Waziup/OSIRRIS/media/4-x-aa-battery-holder-with-on-off-switch-01_600x600_600x600.png

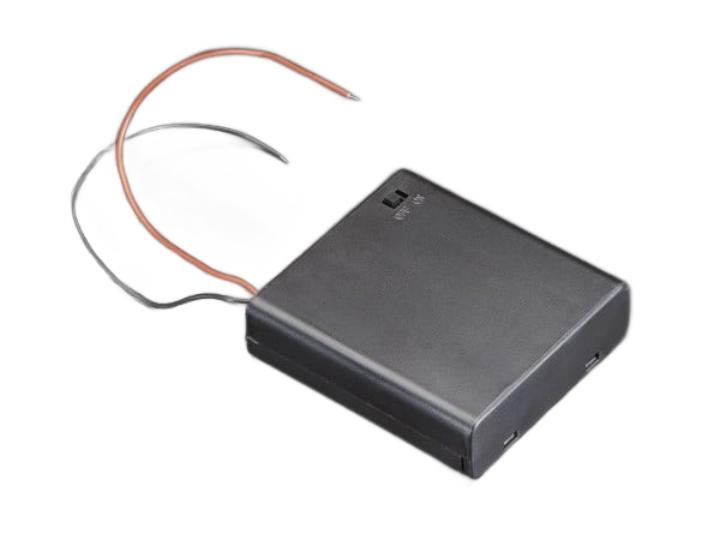
media/4-x-aa-battery-holder-with-on-off-switch-01_600x600_600x600.png
