Waziup/OSIRRIS/media/20221110_152509.jpg

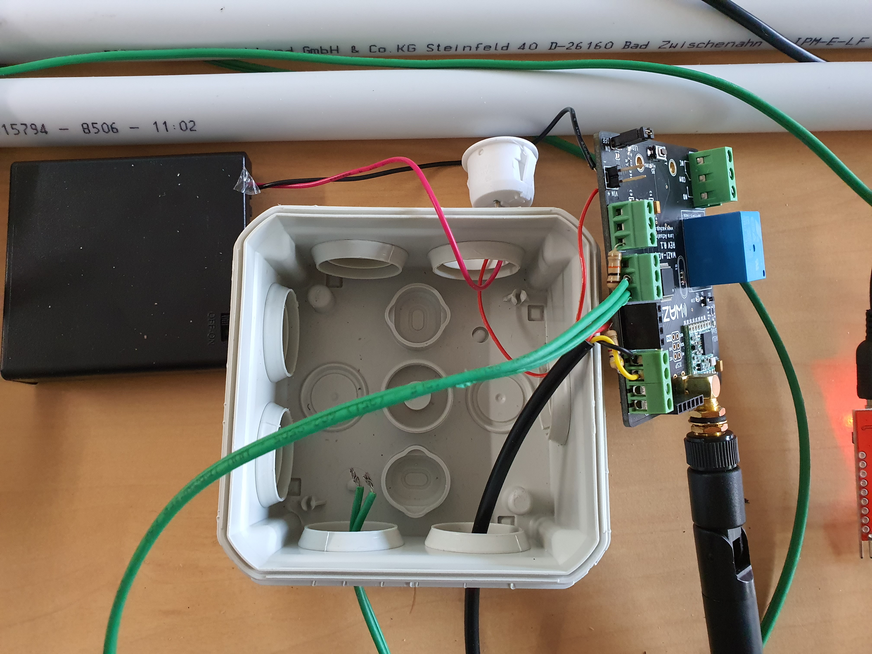
media/20221110_152509.jpg
