Waziup/OSIRRIS/media/20221110_152630.jpg

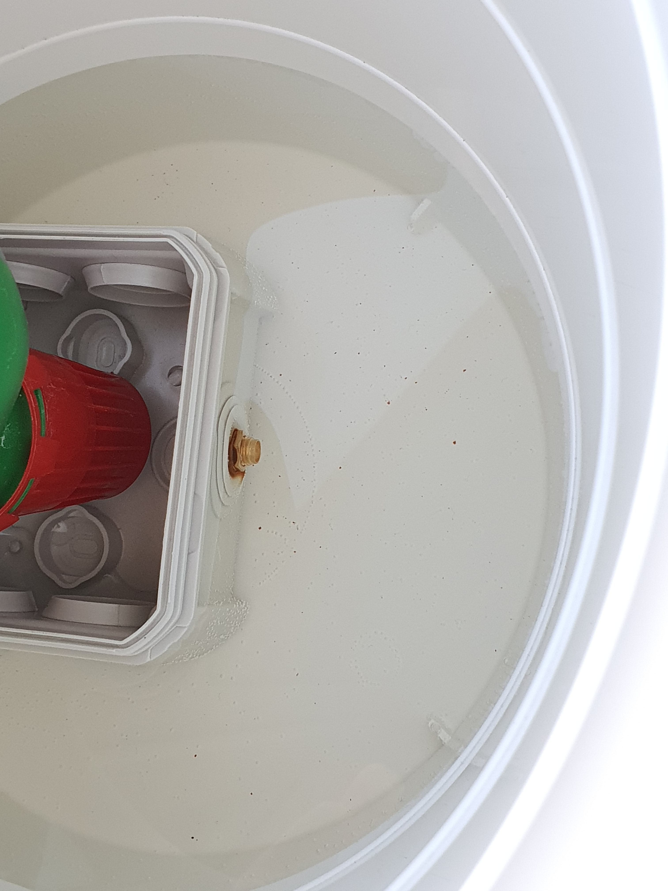
media/20221110_152630.jpg
