Waziup/OSIRRIS/media/20221111_155751_001.jpg

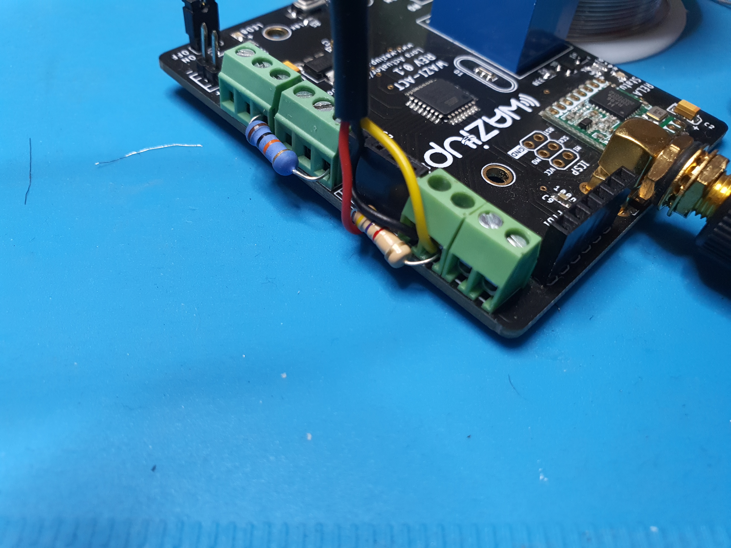
media/20221111_155751_001.jpg
