Waziup/OSIRRIS/media/20221114_112446.jpg

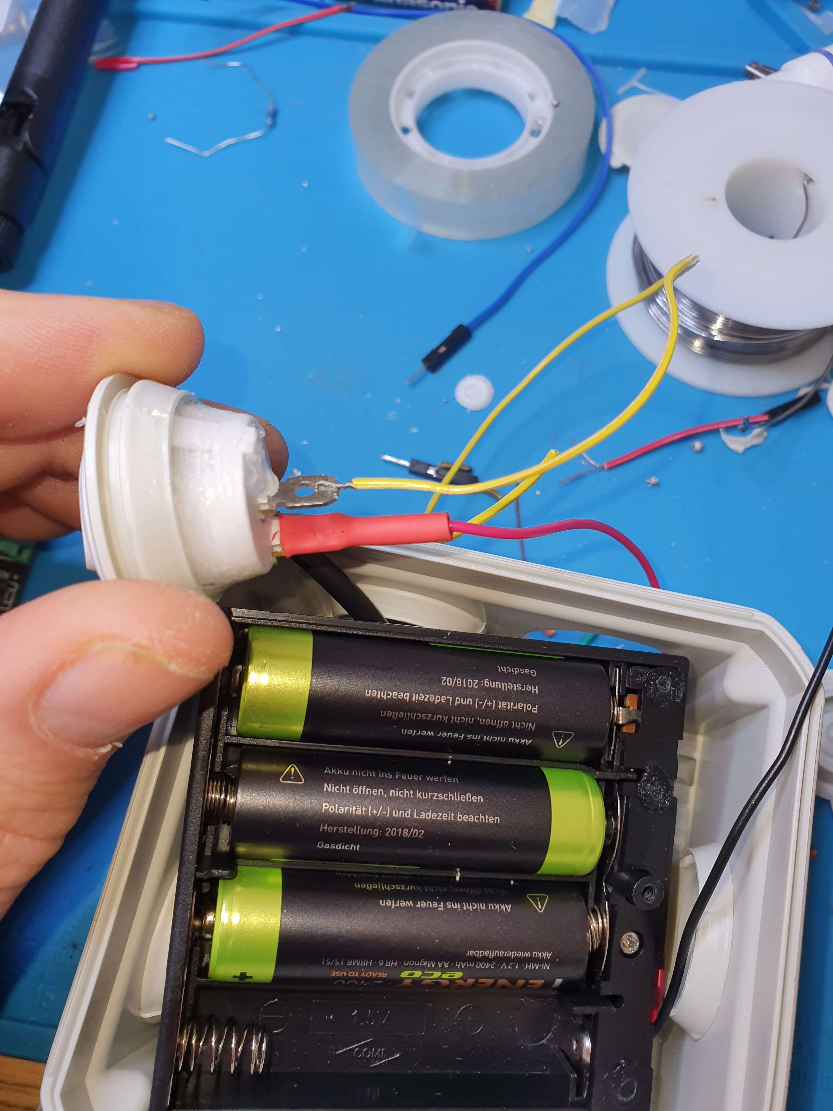
media/20221114_112446.jpg
