Waziup/OSIRRIS/media/20221117_125420.jpg

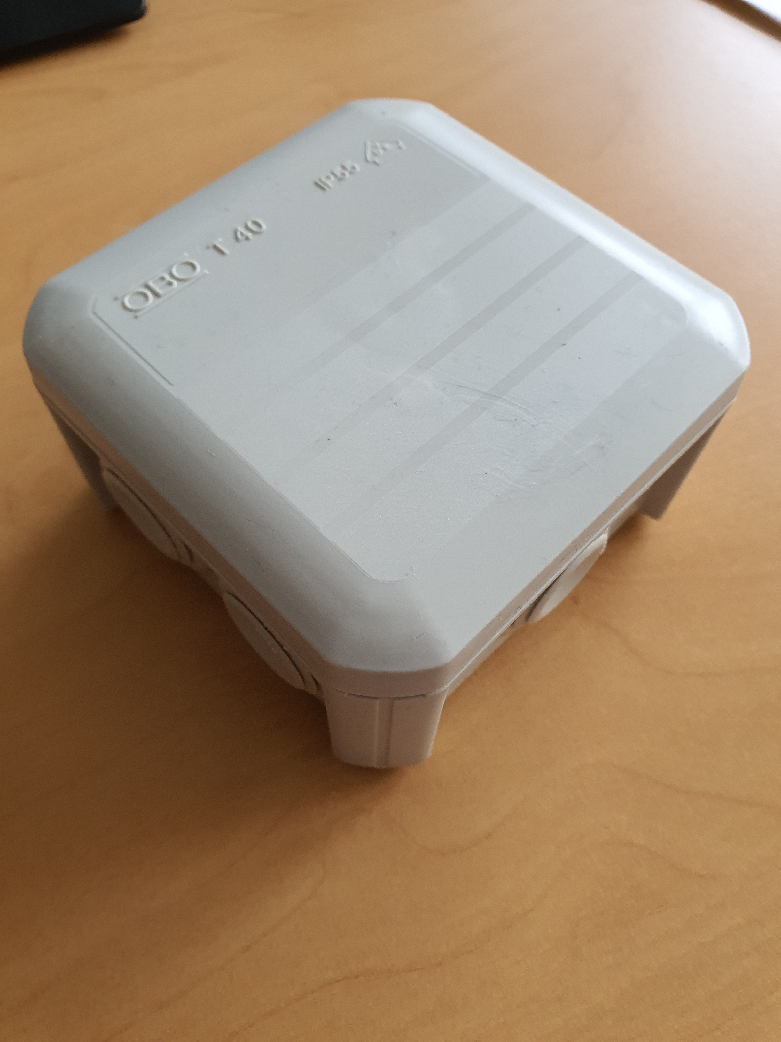
media/20221117_125420.jpg
