Waziup/OSIRRIS/media/20221117_125453.jpg

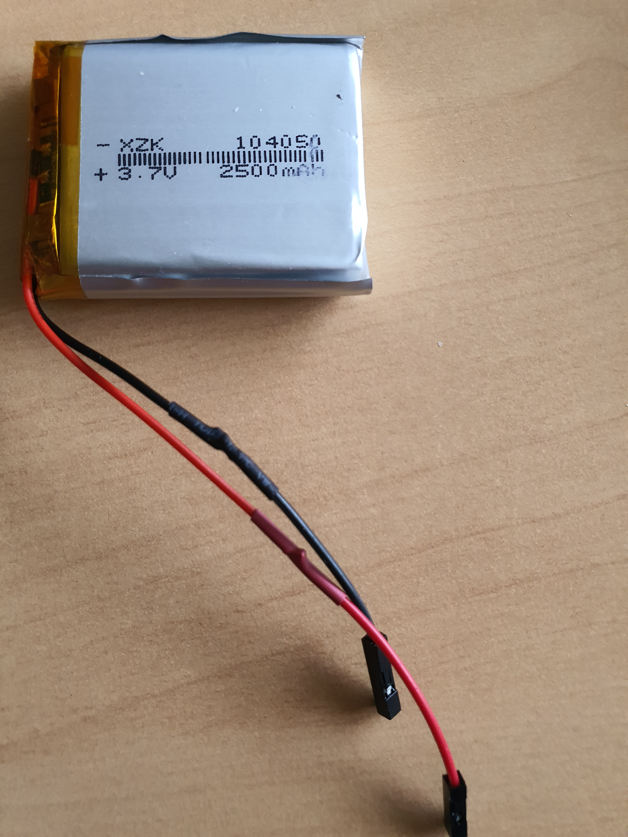
media/20221117_125453.jpg
