Waziup/OSIRRIS/media/20221117_125513.jpg

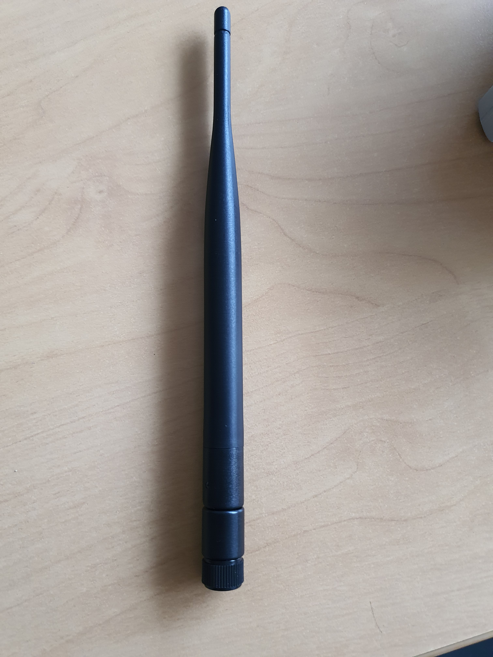
media/20221117_125513.jpg
