Waziup/OSIRRIS/media/20221118_125738_001.jpg

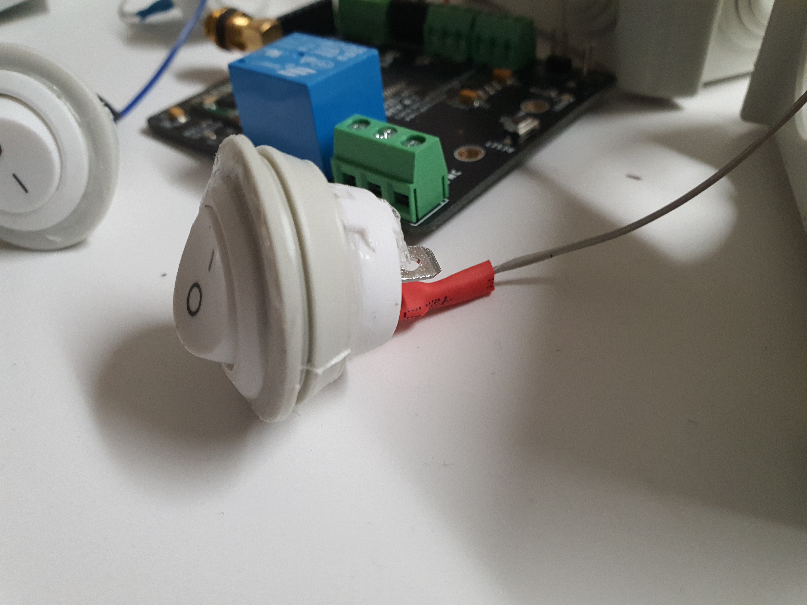
media/20221118_125738_001.jpg
