Waziup/OSIRRIS/media/20221121_114306.jpg

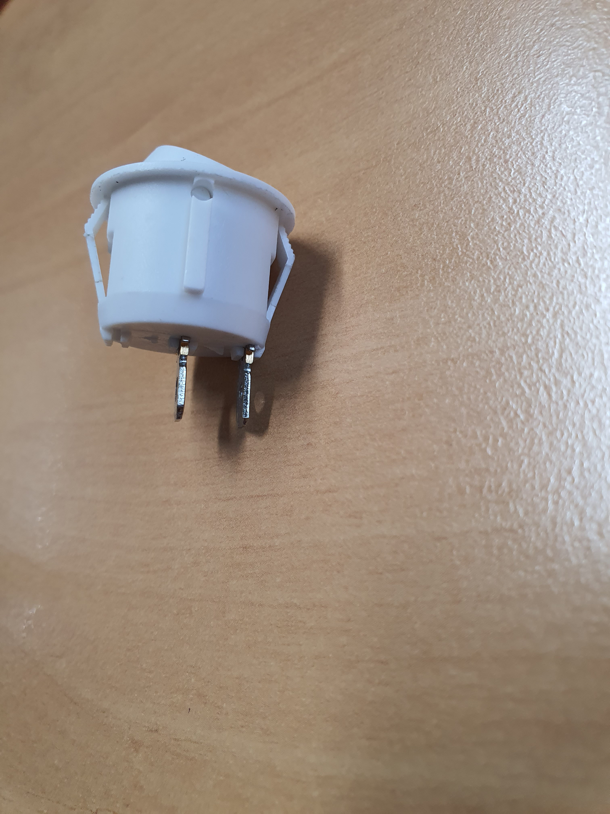
media/20221121_114306.jpg
