Waziup/OSIRRIS/media/20221121_114306.png

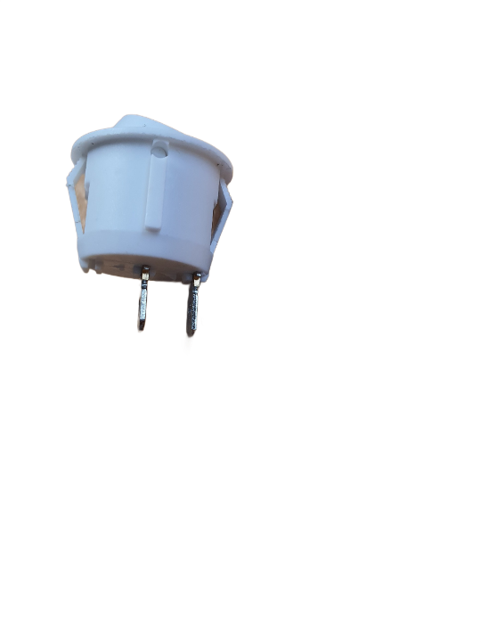
media/20221121_114306.png
