Waziup/OSIRRIS/media/antenna.png

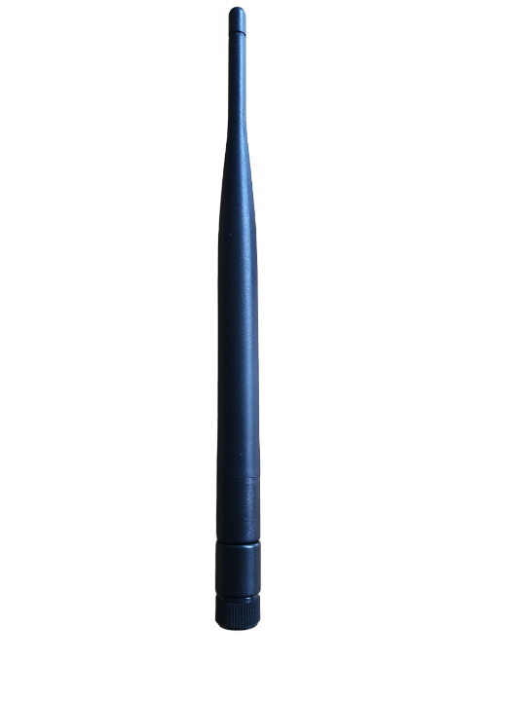
media/antenna.png
