Waziup/OSIRRIS/media/battery.png

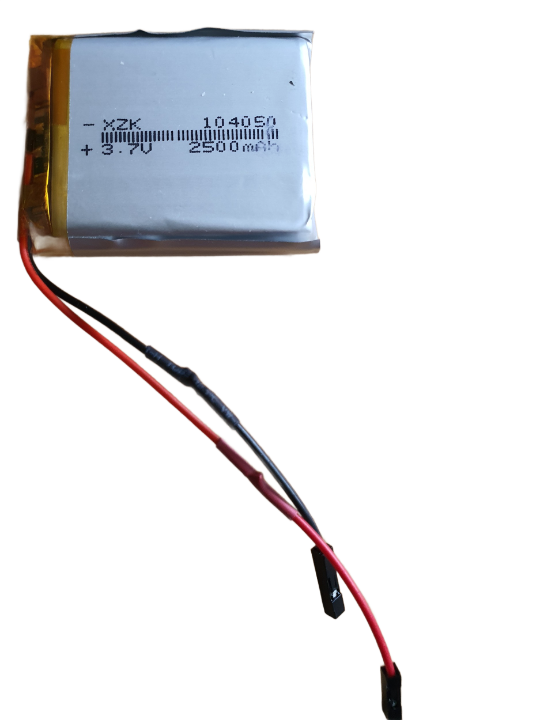
media/battery.png
