Waziup/OSIRRIS/media/box.png

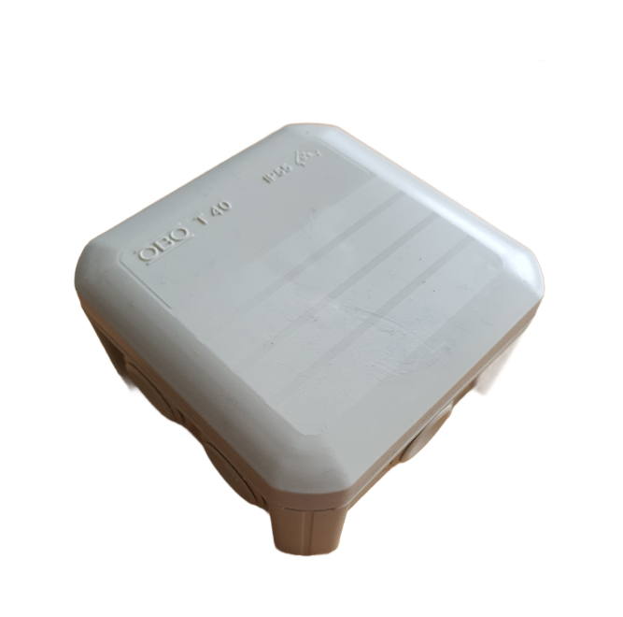
media/box.png
