Waziup/OSIRRIS/media/drip_irrigation.jpg

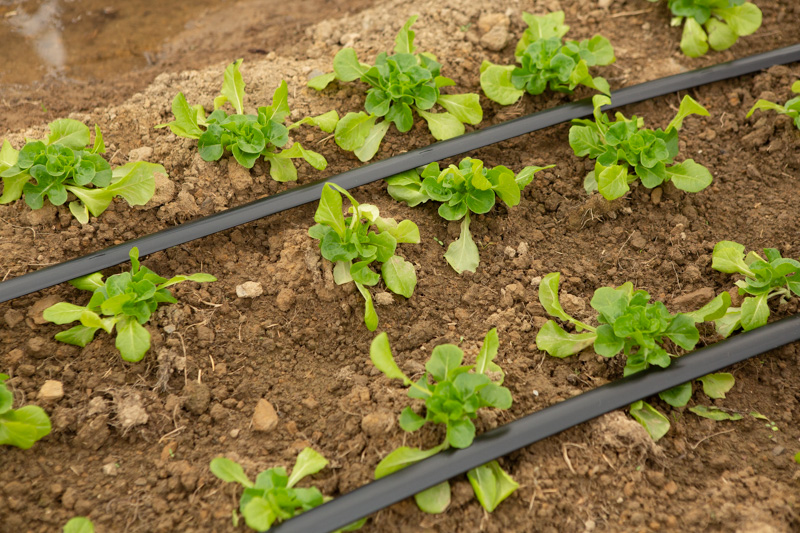
media/drip_irrigation.jpg
