Waziup/OSIRRIS/media/IMG_6713a_0349af94-5212-41f6-b86e-f112ee11bd61_2048x2048.webp

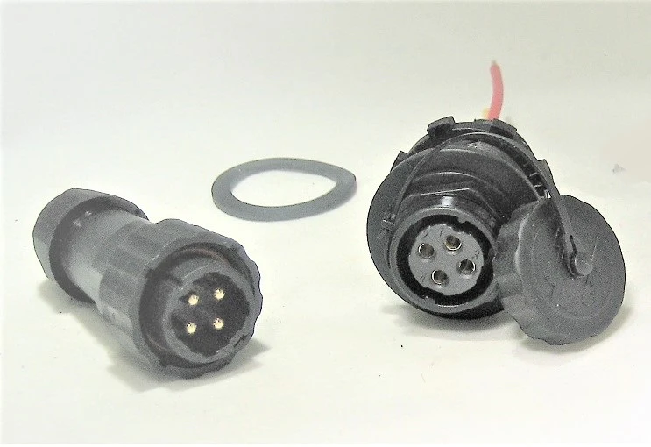
media/IMG_6713a_0349af94-5212-41f6-b86e-f112ee11bd61_2048x2048.webp
