Waziup/OSIRRIS/media/jumpers.jpg

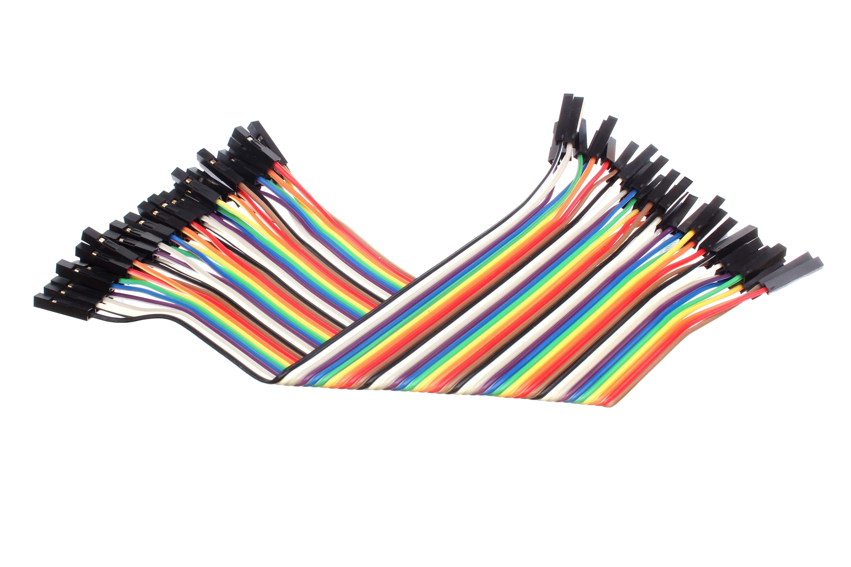
media/jumpers.jpg
