Waziup/OSIRRIS/media/s-l1600.jpg

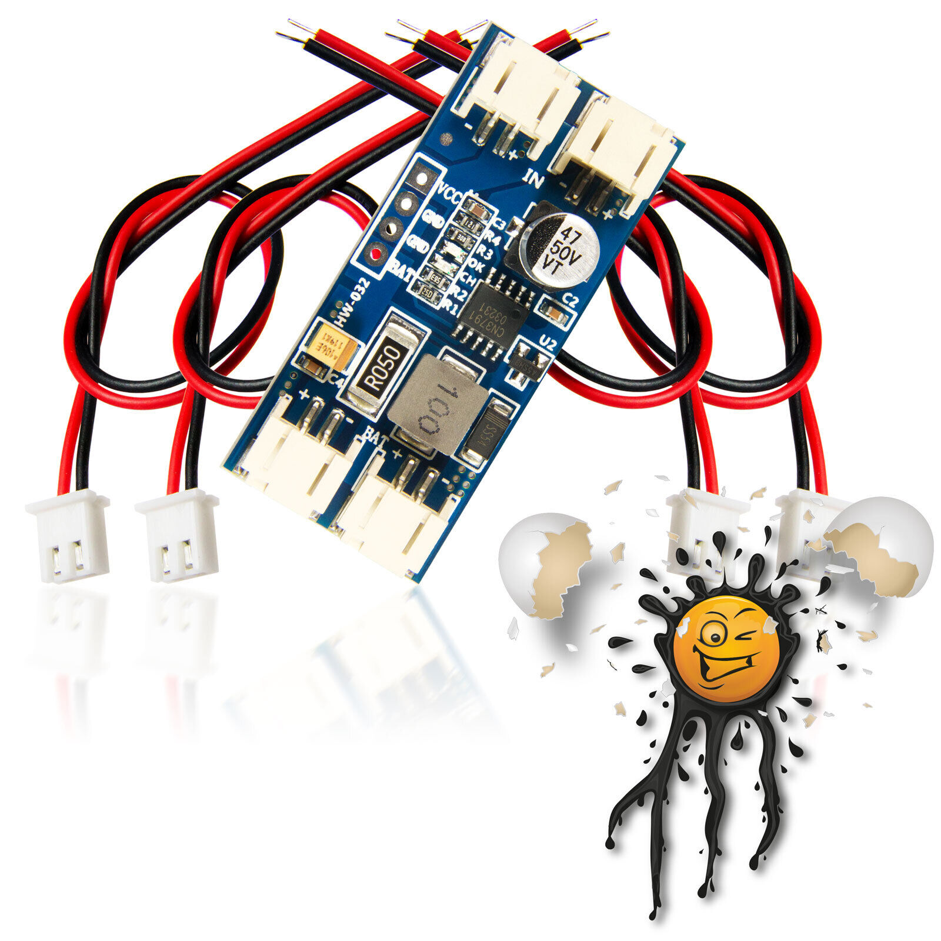
media/s-l1600.jpg
