Waziup/OSIRRIS/media/s-l1600.png

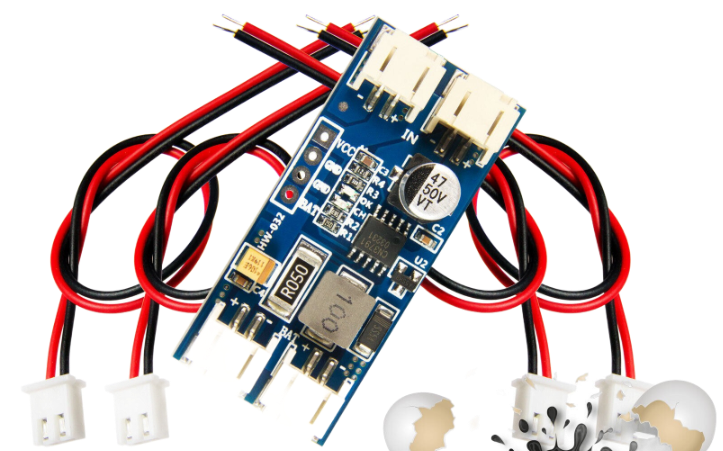
media/s-l1600.png
