Waziup/OSIRRIS/media/Sensor_DS18B20.jpg

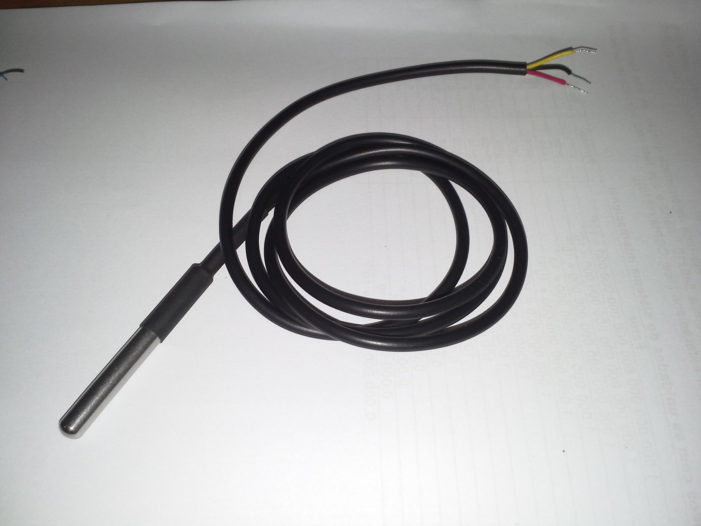
media/Sensor_DS18B20.jpg
