Waziup/OSIRRIS/media/Sensor_DS18B20.png

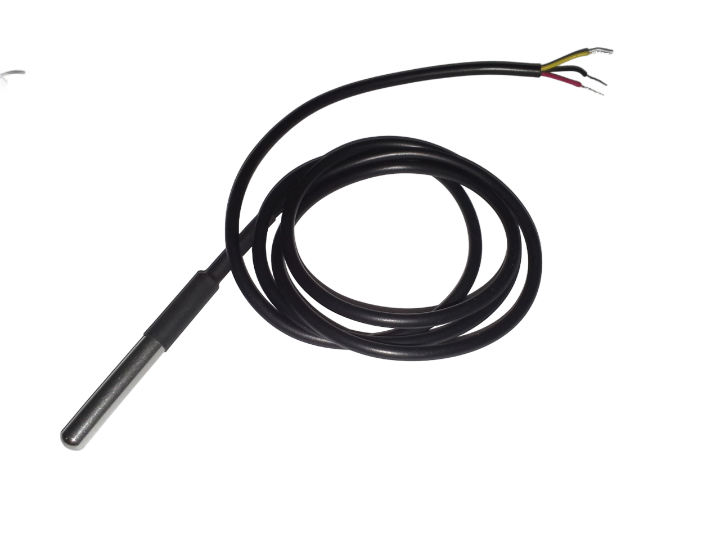
media/Sensor_DS18B20.png
