Waziup/OSIRRIS/media/solar.jpg

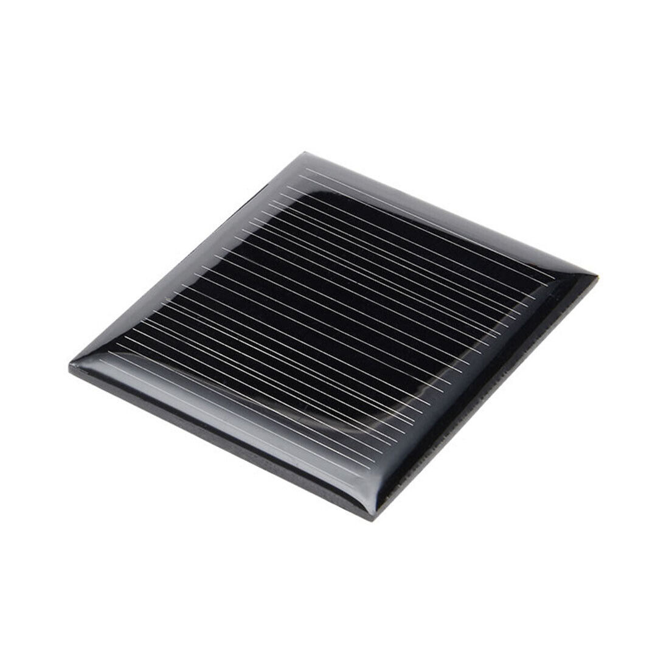
media/solar.jpg
