Waziup/OSIRRIS/media/watermark-sensor.jpg

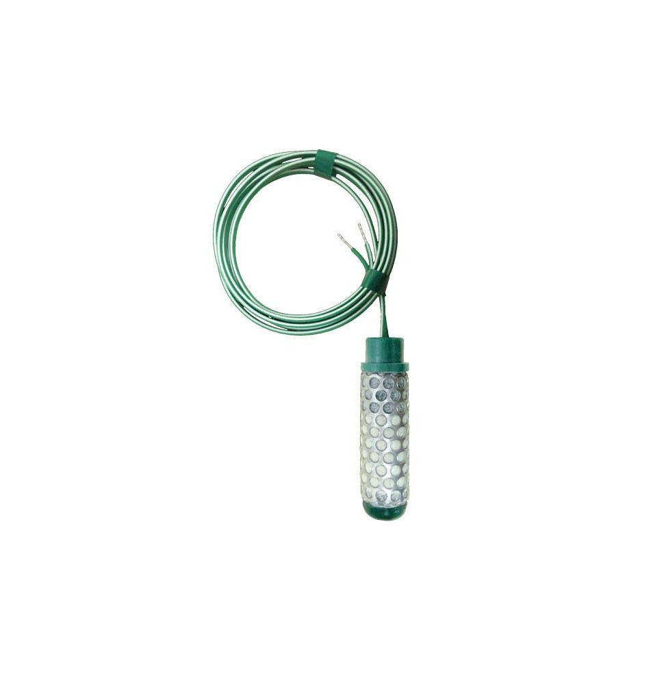
media/watermark-sensor.jpg
