Waziup/OSIRRIS/media/WaziAct.png

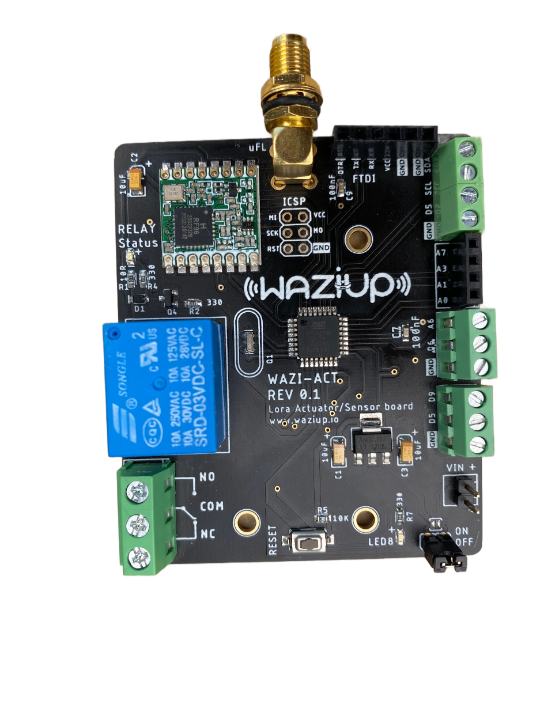
media/WaziAct.png
