Waziup/OSIRRIS/Guides/irrigation_prediction_guide.md

# WaziApp: Irrigation Prediction Guide

This guide shows how to configure and use the WaziAPP irrigation prediction.

## Requirements

In the following, we will go over all 
you need to deploy the WaziGate, it is explained in the following guide, [here](./prepared_deploy_guide.md). Afterwards
