Waziup/OSIRRIS/Guides/media/20240131_105928.jpg

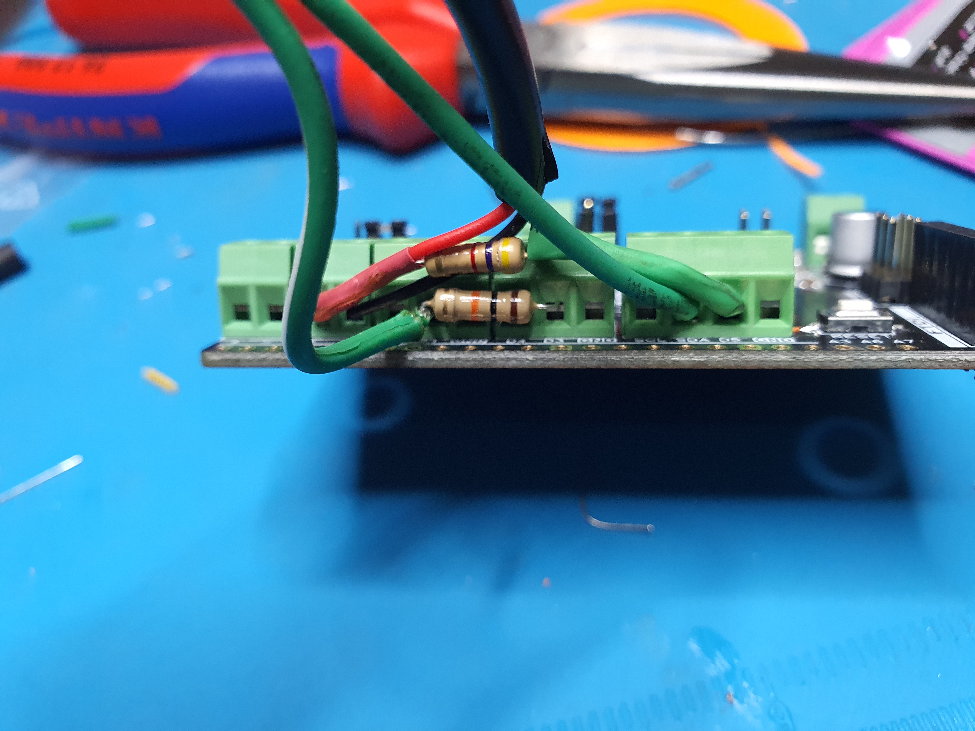
Guides/media/20240131_105928.jpg
