Waziup/OSIRRIS/Guides/media/20240131_105938.jpg

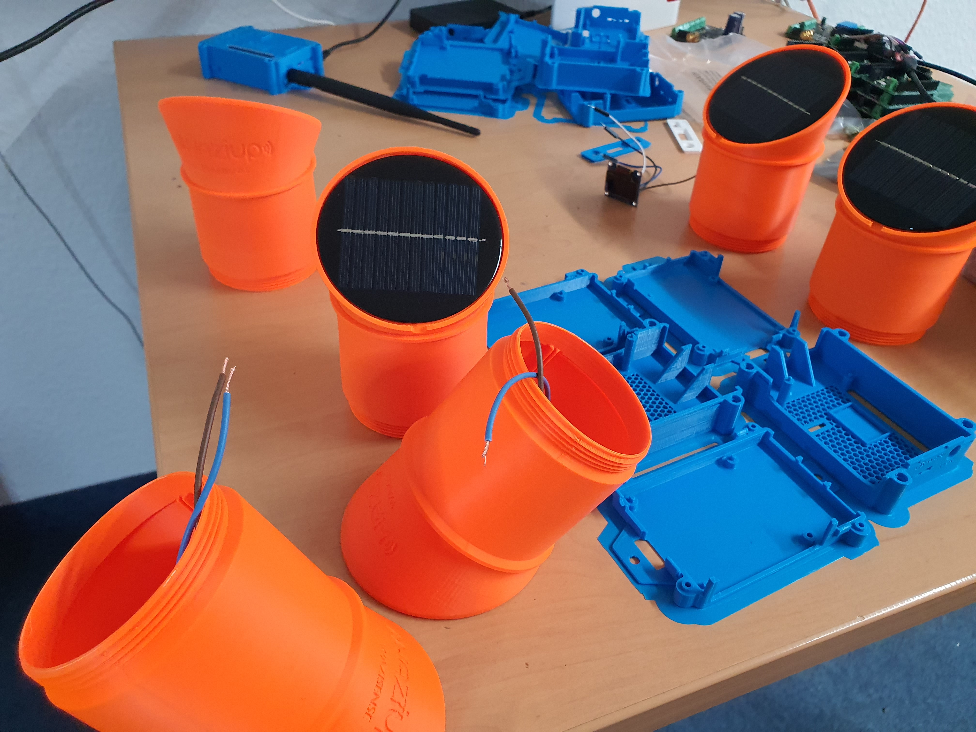
Guides/media/20240131_105938.jpg
