Waziup/OSIRRIS/Guides/media/20240131_105957.jpg

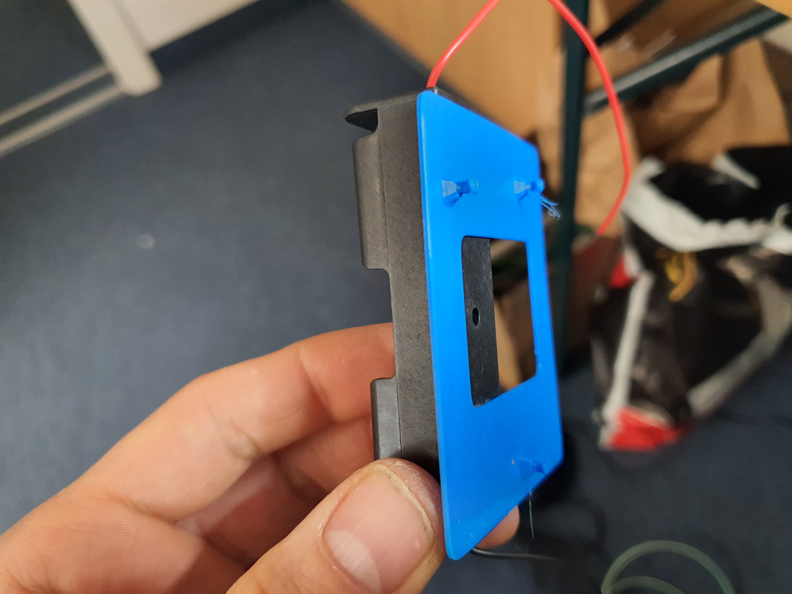
Guides/media/20240131_105957.jpg
