Waziup/OSIRRIS/Guides/media/20240131_143156.jpg

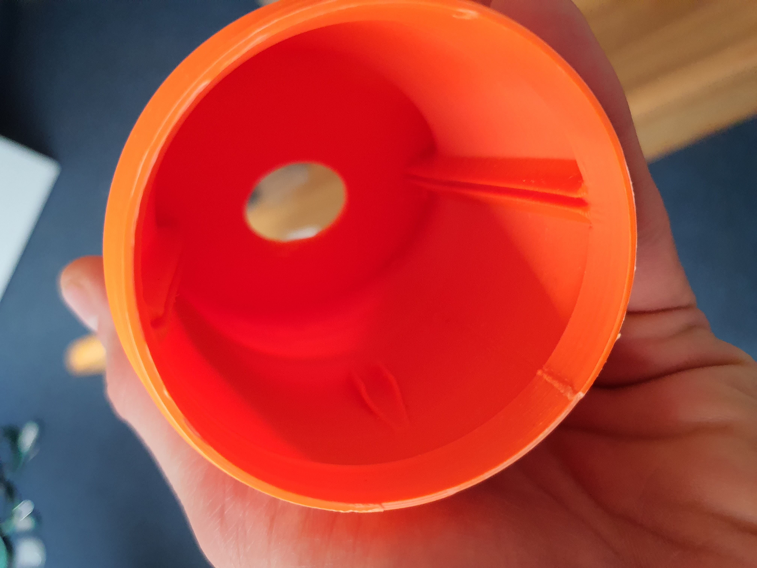
Guides/media/20240131_143156.jpg
