Waziup/OSIRRIS/Guides/media/20240201_104939.jpg

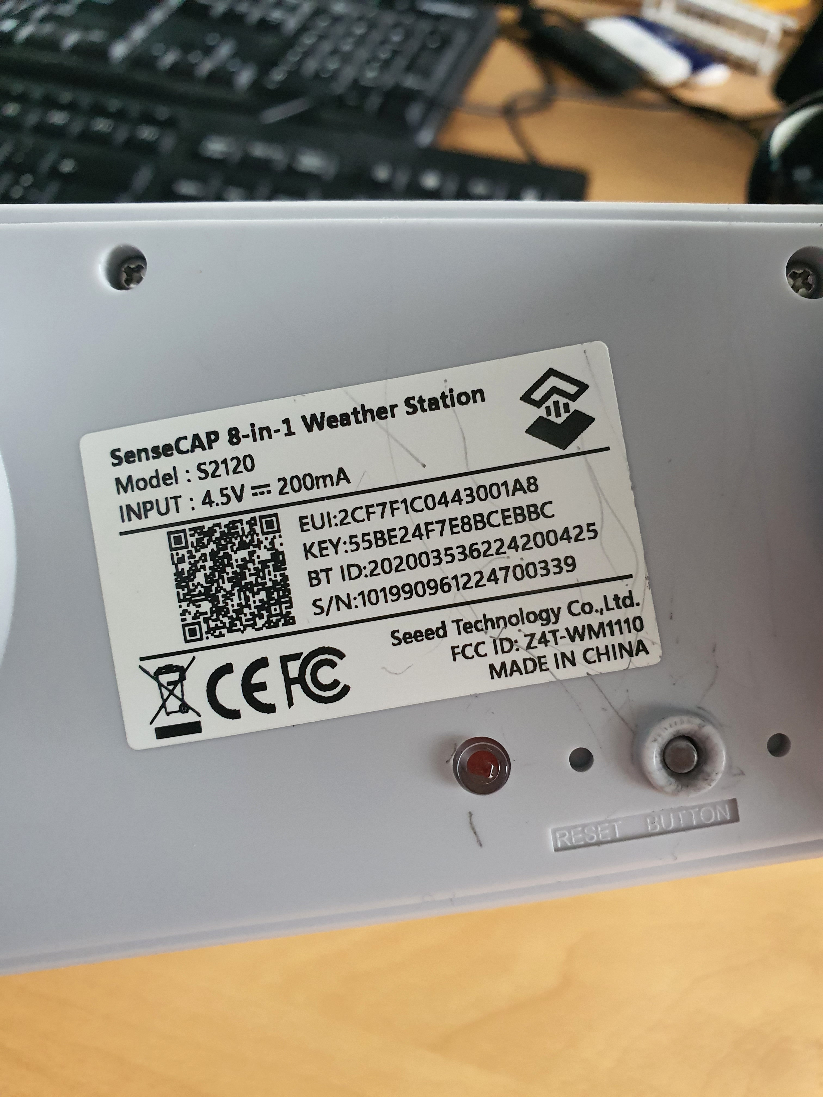
Guides/media/20240201_104939.jpg
