Waziup/OSIRRIS/Guides/media/irrigation_prediction_charts_1.png

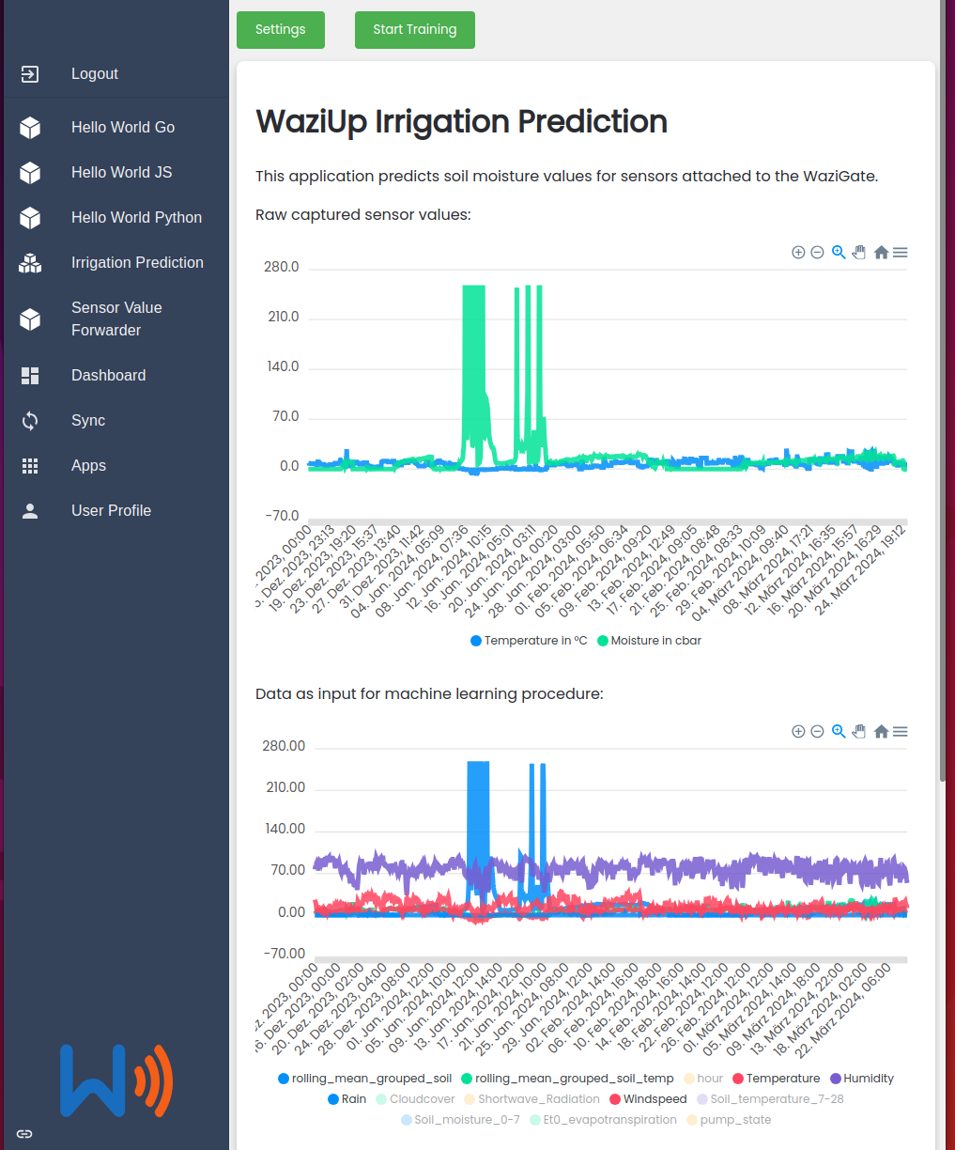
Guides/media/irrigation_prediction_charts_1.png
