Waziup/OSIRRIS/Guides/media/irrigation_prediction_charts_2.png

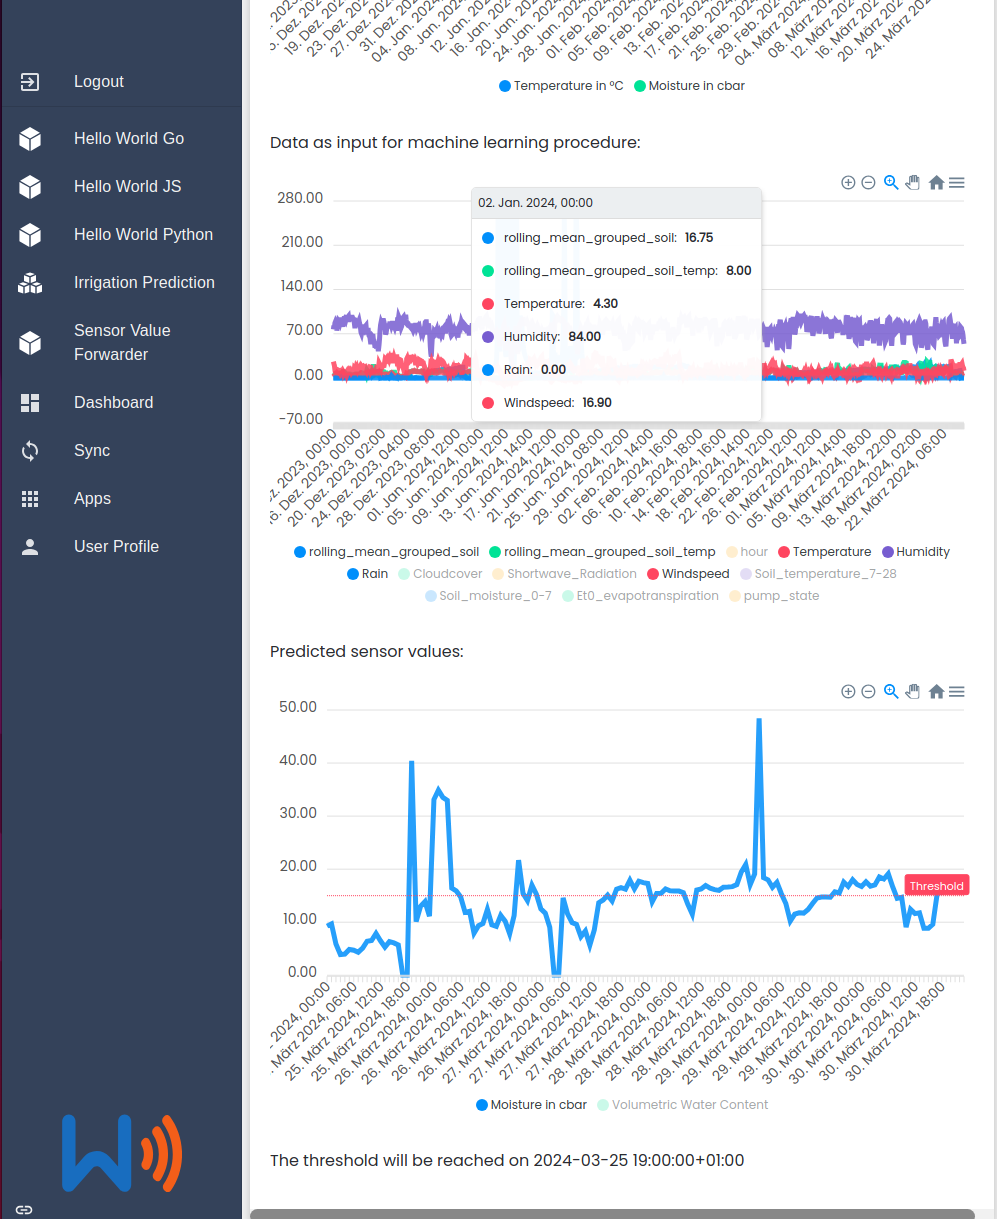
Guides/media/irrigation_prediction_charts_2.png
