Waziup/OSIRRIS/Guides/media/Screenshot_20231012-124507_SenseCAP.jpg

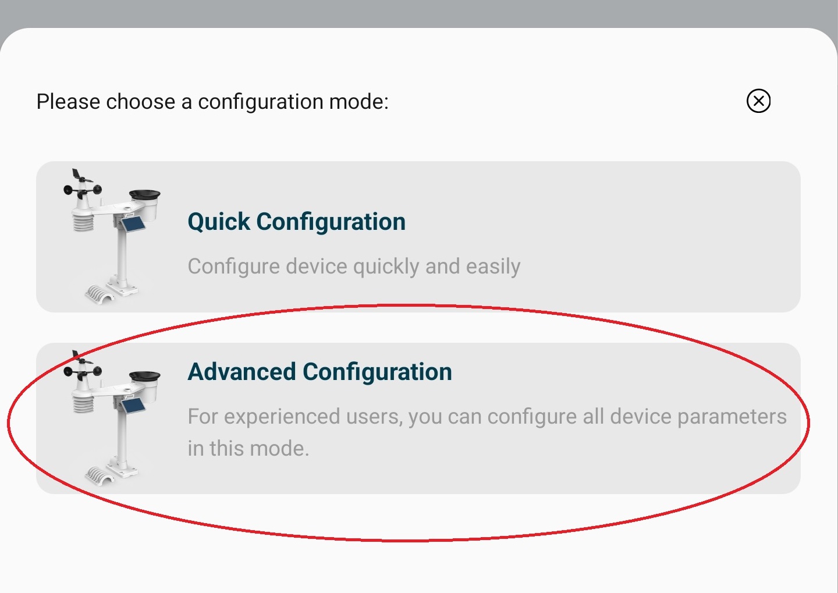
Guides/media/Screenshot_20231012-124507_SenseCAP.jpg
