Waziup/OSIRRIS/(commit log)

2022-11-18 added Arduino code and libraries
    [watermark.xlsx]
2022-12-05 added pump state script, changes to OSIRRIS script
2026-06-11 DS18B20 wrong reading fix, guide
    [Osirris_Soil_Sensor.ino, SX126X_RadioSettings.h, SX127X_RadioSettings.h]
