Waziup/OSIRRIS/media/20221111_155901.jpg

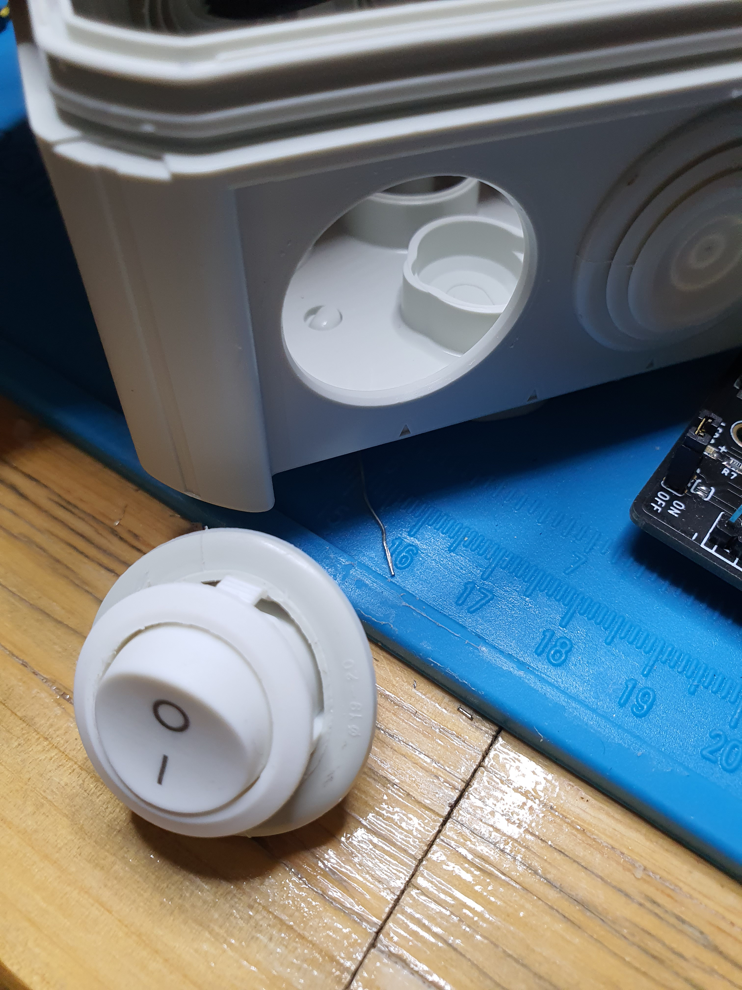
media/20221111_155901.jpg
