Waziup/OSIRRIS/Guides/media/20240129_123927.jpg

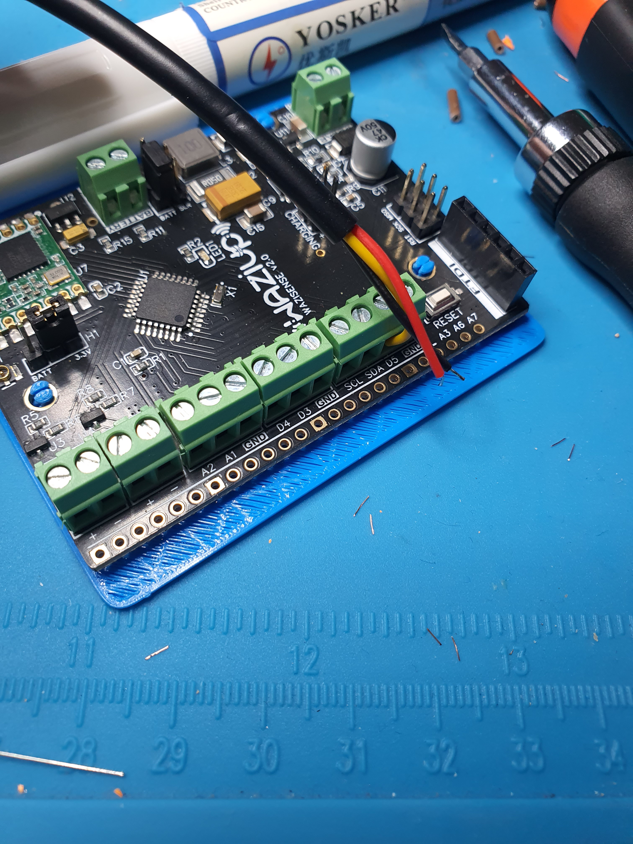
Guides/media/20240129_123927.jpg
