Waziup/OSIRRIS/Guides/media/20240131_105913.jpg

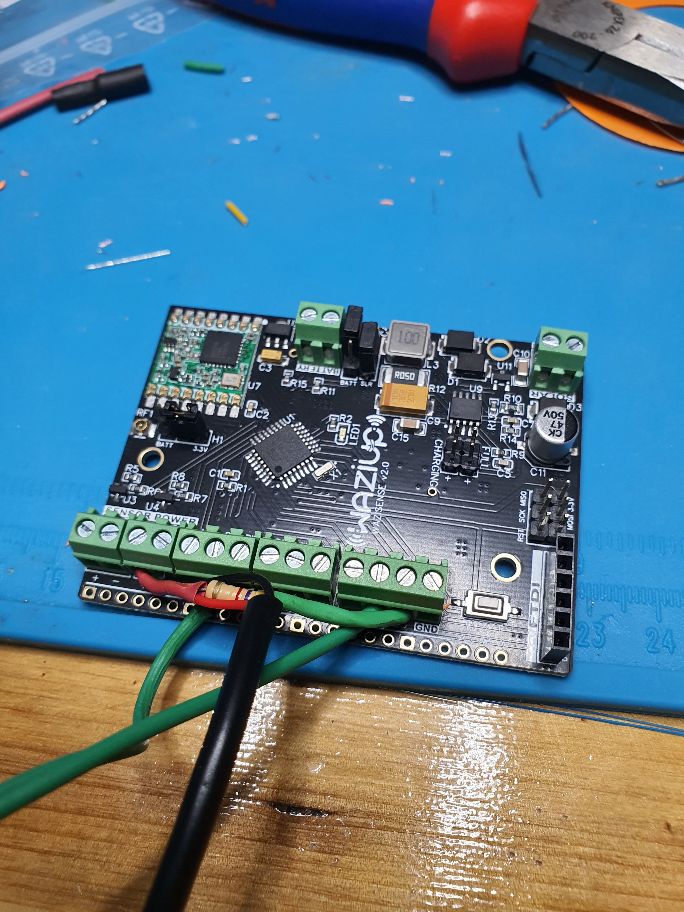
Guides/media/20240131_105913.jpg
