Waziup/OSIRRIS/Guides/media/20240131_143354.jpg

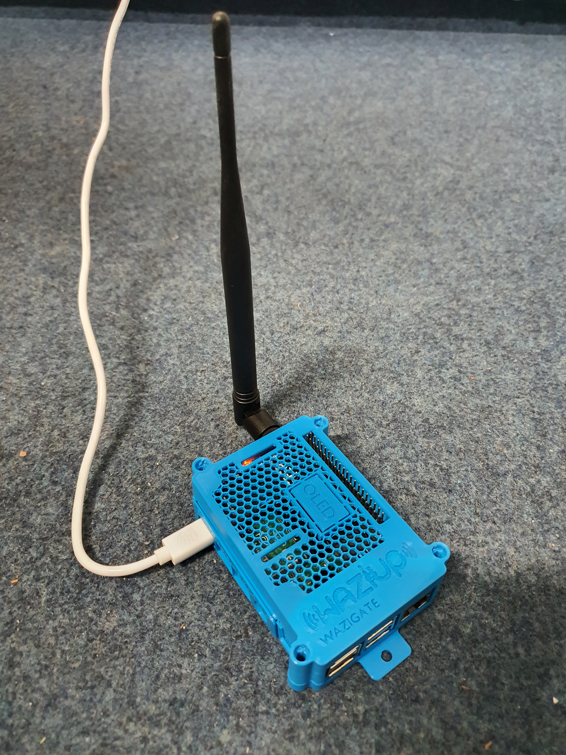
Guides/media/20240131_143354.jpg
